insidegadgets/Flash2Verify/README.md

Flash2Verify allows you insert supported 5V flash chips to a TSOP48 socket to write 
and read the contents back to verify that it works correctly. Useful if you would like 
to know the flash chip works before soldering it to a PCB.

Licensed under GPL.

Supported chips:
* AM29F016B

**Built (old PCB revision)**

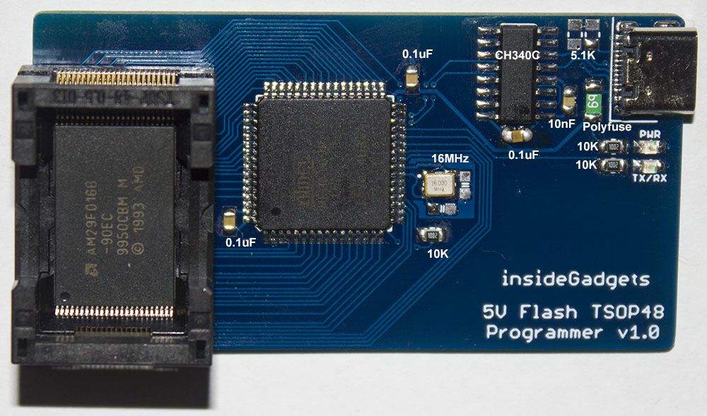
[picture p1: Pictures/Flash2Verify_Built.jpg]
Built


**PCB Option 1**

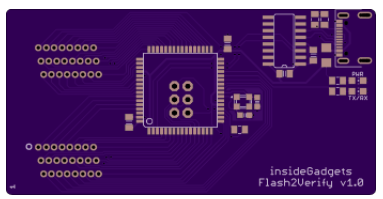
[picture p2: Pictures/Flash2Verify_PCB_Option_1.png]
PCB 1


**PCB Option 2**

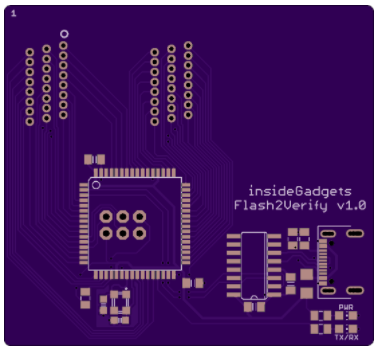
[picture p3: Pictures/Flash2Verify_PCB_Option_2.png]
PCB 2


**Software**

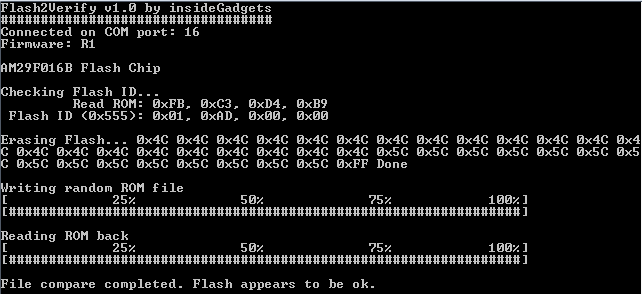
[picture p4: Pictures/Flash2Verify_Software.png]
Software
