insidegadgets/Flash2Verify/PCB/Parts.txt

1	CH340C
1	ATMEGA169P-15AT
1	16MHz 3225 4P crystal

1	100-250mA Polyfuse 1206
1	Red 0805 LED
1	Blue 0805 LED
3	10K 0805 Resistor
2	5.1K 0805 Resistor
3	0.1uF 0805 Capacitor
1	10nF Capacitor

1	USB-C 16pin Connector (C393939 LCSC)
1	TSOP 48 Socket For Programmer https://www.aliexpress.com/item/32960588536.html
