insidegadgets/Flash2Verify/PCB/Flash2Verify_v1.0.sch

## EAGLE design PCB/Flash2Verify_v1.0.sch (2020-08-15)

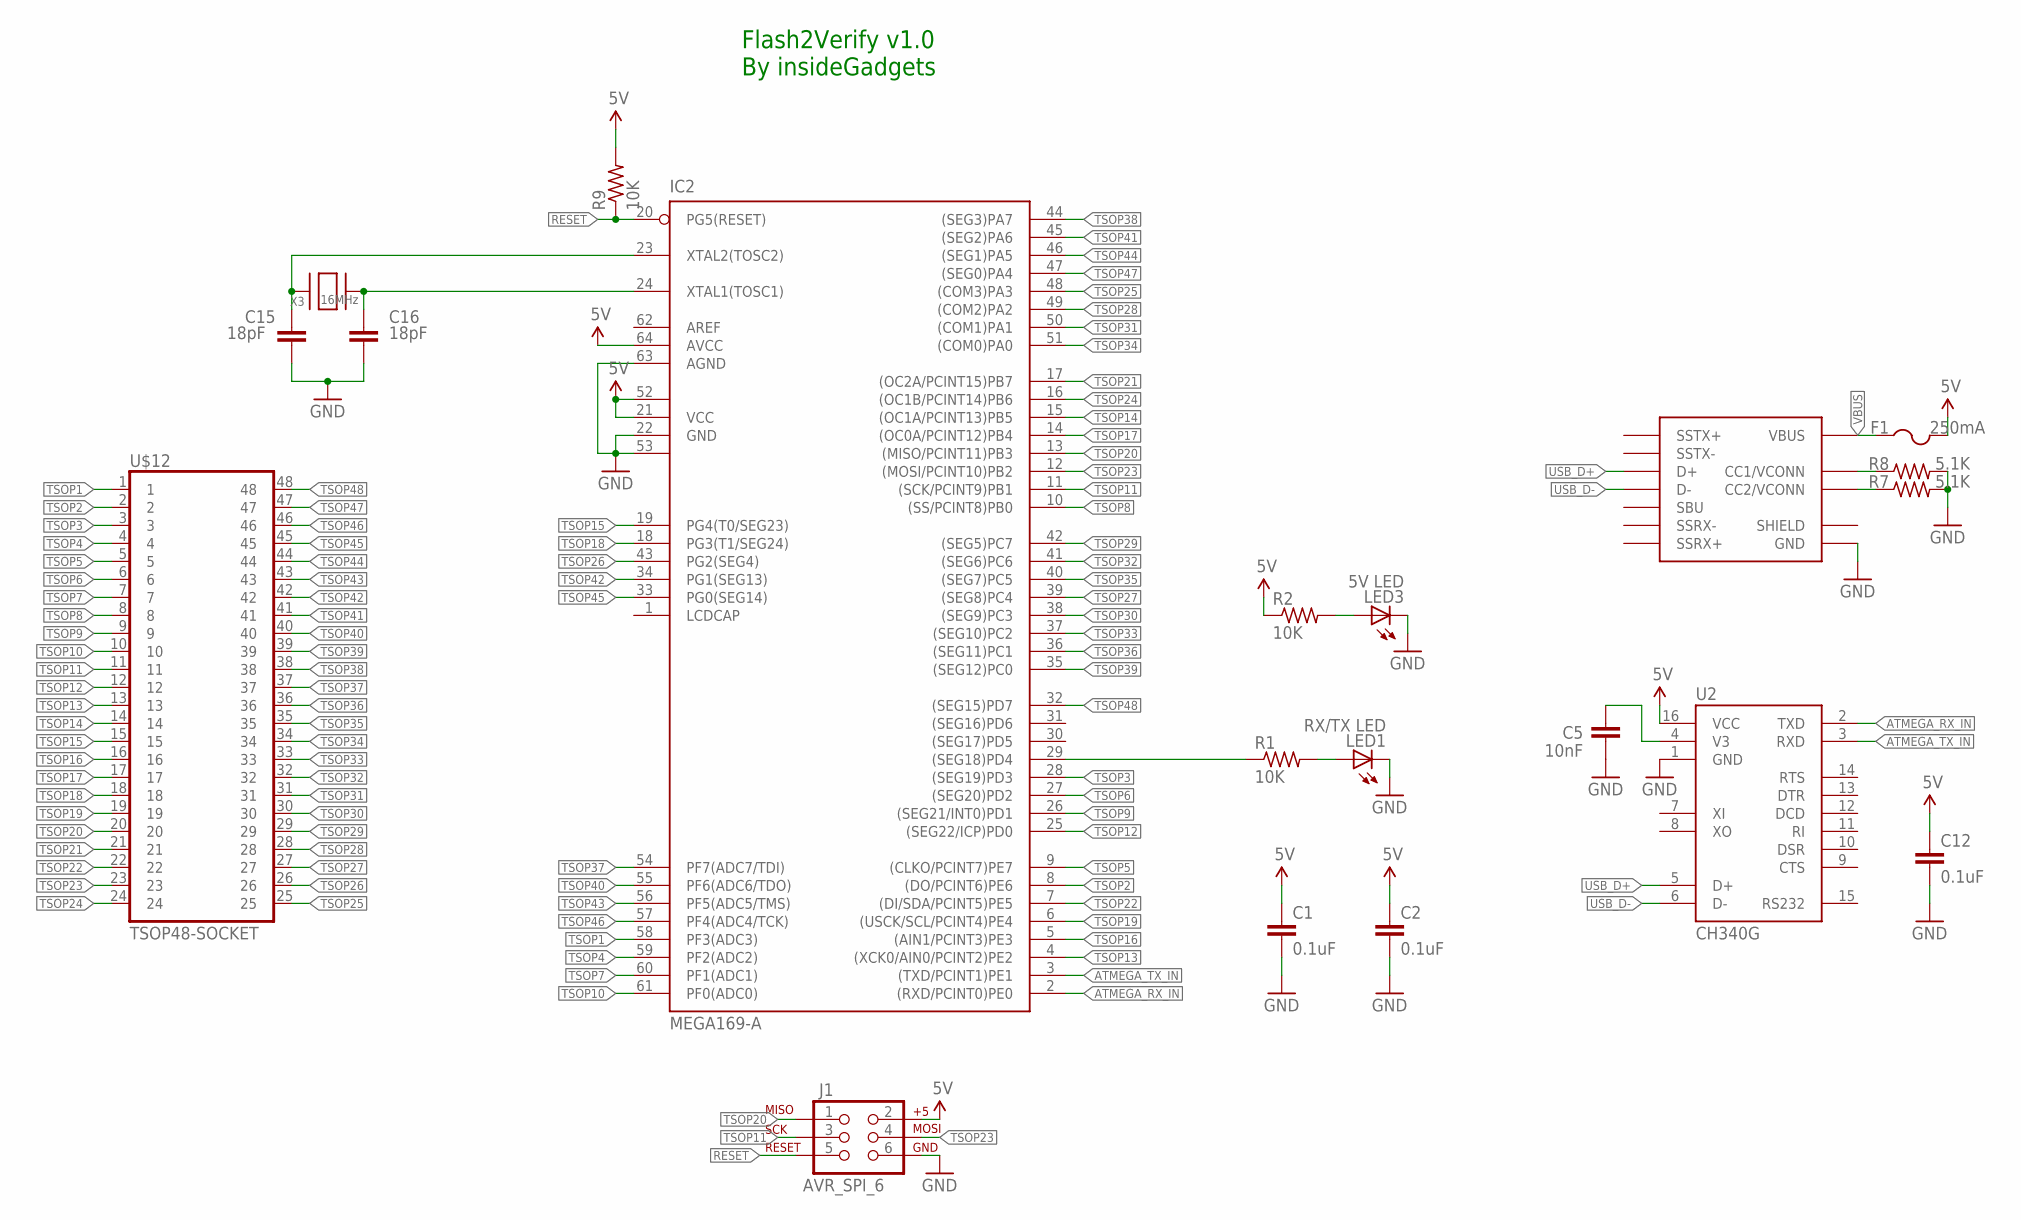
[picture p5: schematic Flash2Verify_v1.0.sch]

Parts:
C1, C2, C12: 0.1uF; C0805K
C5: 10nF; C0805K
C15, C16: 18pF; C0603K
F1: 250mA; R1206
IC2: MEGA169-A; TQFP64
J1: AVR_SPI_6; 2X3_2
LED1: RX/TX LED; CHIP-LED0805-NS
LED3: 5V LED; CHIP-LED0805-NS
R1, R2, R9: 10K; R0805_2
R7, R8: 5.1K; R0805_2
U2: CH340G; SO16
U$3: USB-TYPE-CC393939; USB-TYPE-C-C393939
U$12: TSOP48-SOCKET
X3: 16MHz; XTAL32-25

Connections:
5V: C1.1, C2.1, C12.1, F1.2, IC2.21 (VCC), IC2.52 (VCC1), IC2.64 (AVCC), J1.2, R2.1, R9.2, U2.16 (VCC)
ATMEGA_RX_IN: IC2.2 ((RXD/PCINT0)PE0), U2.2 (TXD)
ATMEGA_TX_IN: IC2.3 ((TXD/PCINT1)PE1), U2.3 (RXD)
GND: C1.2, C2.2, C5.2, C12.2, C15.2, C16.2, IC2.22 (GND), IC2.53 (GND1), IC2.63 (AGND), J1.6, LED1.C, LED3.C, R7.2, R8.2, U2.1 (GND), U$3.1 (GND)
unnamed: R7.1, U$3.10 (CC2/VCONN)
unnamed: IC2.29 ((SEG18)PD4), R1.1
unnamed: LED3.A, R2.2
unnamed: R8.1, U$3.4 (CC1/VCONN)
unnamed: LED1.A, R1.2
RESET: IC2.20 (PG5(RESET)), J1.5, R9.1
TSOP1: IC2.58 (PF3(ADC3)), U$12.1
TSOP2: IC2.8 ((DO/PCINT6)PE6), U$12.2
TSOP3: IC2.28 ((SEG19)PD3), U$12.3
TSOP4: IC2.59 (PF2(ADC2)), U$12.4
TSOP5: IC2.9 ((CLKO/PCINT7)PE7), U$12.5
TSOP6: IC2.27 ((SEG20)PD2), U$12.6
TSOP7: IC2.60 (PF1(ADC1)), U$12.7
TSOP8: IC2.10 ((SS/PCINT8)PB0), U$12.8
TSOP9: IC2.26 ((SEG21/INT0)PD1), U$12.9
TSOP10: IC2.61 (PF0(ADC0)), U$12.10
TSOP11: IC2.11 ((SCK/PCINT9)PB1), J1.3, U$12.11
TSOP12: IC2.25 ((SEG22/ICP)PD0), U$12.12
TSOP13: IC2.4 ((XCK0/AIN0/PCINT2)PE2), U$12.13
TSOP14: IC2.15 ((OC1A/PCINT13)PB5), U$12.14
TSOP15: IC2.19 (PG4(T0/SEG23)), U$12.15
TSOP16: IC2.5 ((AIN1/PCINT3)PE3), U$12.16
TSOP17: IC2.14 ((OC0A/PCINT12)PB4), U$12.17
TSOP18: IC2.18 (PG3(T1/SEG24)), U$12.18
TSOP19: IC2.6 ((USCK/SCL/PCINT4)PE4), U$12.19
TSOP20: IC2.13 ((MISO/PCINT11)PB3), J1.1, U$12.20
TSOP21: IC2.17 ((OC2A/PCINT15)PB7), U$12.21
TSOP22: IC2.7 ((DI/SDA/PCINT5)PE5), U$12.22
TSOP23: IC2.12 ((MOSI/PCINT10)PB2), J1.4, U$12.23
TSOP24: IC2.16 ((OC1B/PCINT14)PB6), U$12.24
TSOP25: IC2.48 ((COM3)PA3), U$12.25
TSOP26: IC2.43 (PG2(SEG4)), U$12.26
TSOP27: IC2.39 ((SEG8)PC4), U$12.27
TSOP28: IC2.49 ((COM2)PA2), U$12.28
TSOP29: IC2.42 ((SEG5)PC7), U$12.29
TSOP30: IC2.38 ((SEG9)PC3), U$12.30
TSOP31: IC2.50 ((COM1)PA1), U$12.31
TSOP32: IC2.41 ((SEG6)PC6), U$12.32
TSOP33: IC2.37 ((SEG10)PC2), U$12.33
TSOP34: IC2.51 ((COM0)PA0), U$12.34
TSOP35: IC2.40 ((SEG7)PC5), U$12.35
TSOP36: IC2.36 ((SEG11)PC1), U$12.36
TSOP37: IC2.54 (PF7(ADC7/TDI)), U$12.37
TSOP38: IC2.44 ((SEG3)PA7), U$12.38
TSOP39: IC2.35 ((SEG12)PC0), U$12.39
TSOP40: IC2.55 (PF6(ADC6/TDO)), U$12.40
TSOP41: IC2.45 ((SEG2)PA6), U$12.41
TSOP42: IC2.34 (PG1(SEG13)), U$12.42
TSOP43: IC2.56 (PF5(ADC5/TMS)), U$12.43
TSOP44: IC2.46 ((SEG1)PA5), U$12.44
TSOP45: IC2.33 (PG0(SEG14)), U$12.45
TSOP46: IC2.57 (PF4(ADC4/TCK)), U$12.46
TSOP47: IC2.47 ((SEG0)PA4), U$12.47
TSOP48: IC2.32 ((SEG15)PD7), U$12.48
USB_D+: U2.5 (D+), U$3.6 (D+)
USB_D-: U2.6 (D-), U$3.5 (D-)
V3: C5.1, U2.4 (V3)
VBUS: F1.1, U$3.2 (VBUS)
XTAL1: C16.1, IC2.24 (XTAL1(TOSC1)), X3.2
XTAL2: C15.1, IC2.23 (XTAL2(TOSC2)), X3.1

Notes on the sheet:
Flash2Verify v1.0 By insideGadgets
