insidegadgets/Flash2Verify/PCB/Flash2Verify_ATmega_Pinout.png

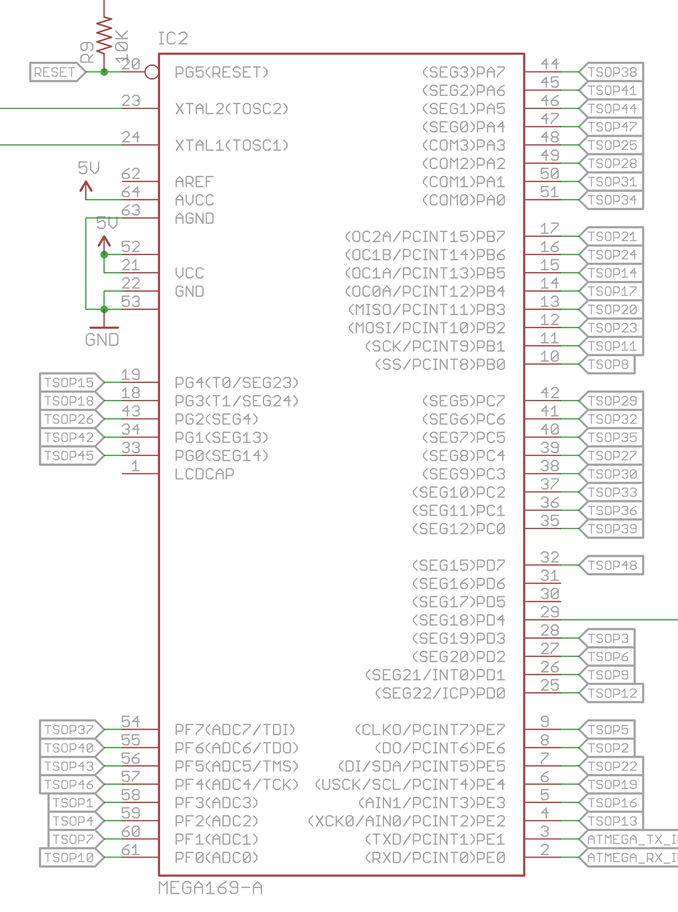
PCB/Flash2Verify_ATmega_Pinout.png
